a-rohr/nermo_arduino_client/(list of files, drawings)

Other design files:
pcb/PCB_Connector_Board_4_2021-09-09.pcbdoc
