a-rohr/nermo_arduino_client/(commit log)

2022-01-02 transferred arduino code to open repo
2022-01-02 transfer of CAD and electrical design to github repo
    [PCB_Connector_Board_4_2021-09-09.pcbdoc]
